shimniok/SerialLCDBackpack/README.md

# SerialLCDBackpack
Serial interface backpack for HD44780 LCD character displays
