shimniok/SerialLCDBackpack/electronics/serlcd841.brd

## EAGLE design electronics/serlcd841.brd (2021-02-10)

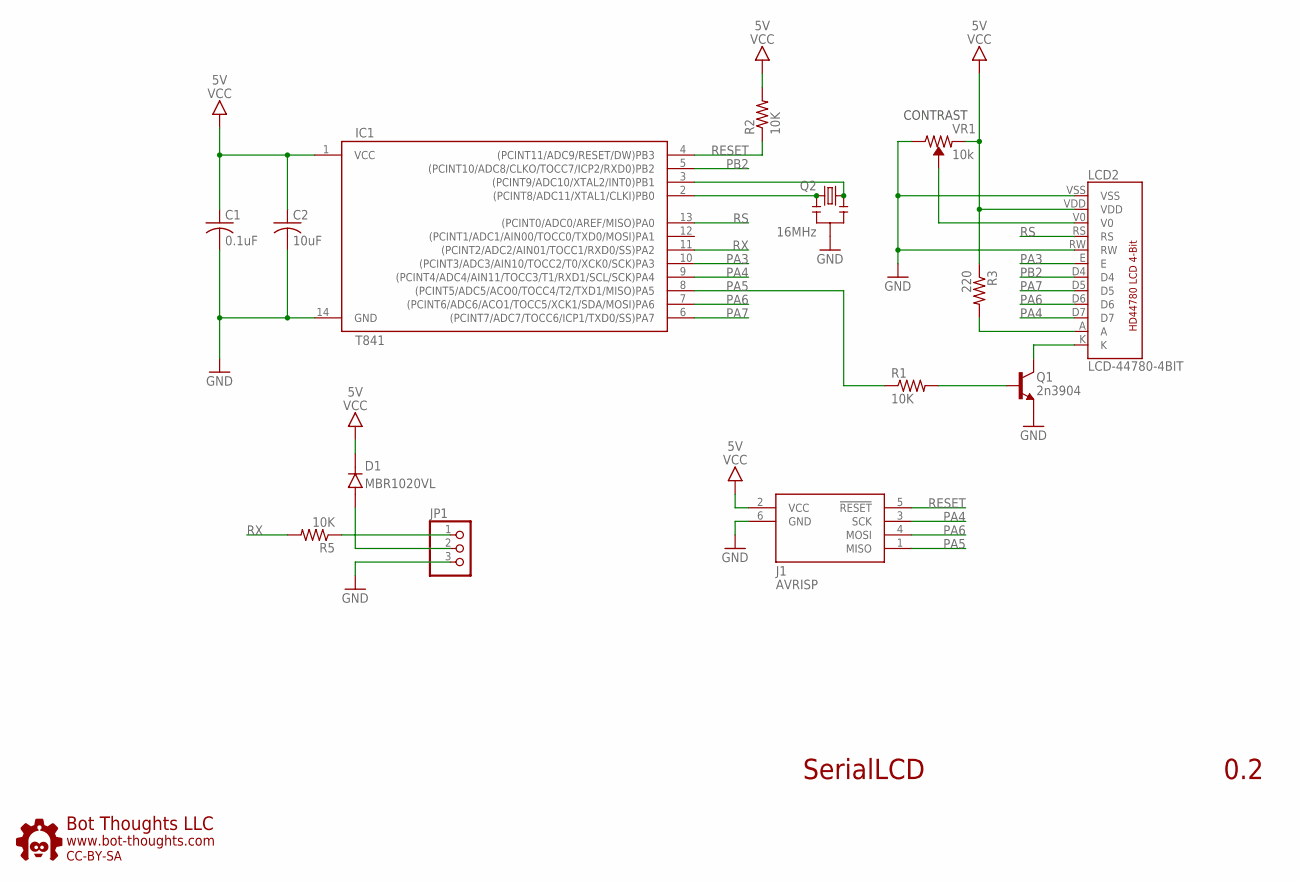
[picture p1: schematic serlcd841.sch]

Parts:
C1: 0.1uF; 0603
C2: 10uF; 1206
D1: MBR1020VL; SOD123FL
IC1: T841; SOIC14N
J1: AVRISP; CON6P2R
JP1: PINHD-1X03_2.54-S; 1X03-S
LCD2: LCD-44780-4BIT; LCD16SIP
Q1: 2n3904; SOT-23
Q2: 16MHz; CSTCE_V_C
R1, R2, R5: 10K; 0603
R3: 220; 0603
U$6: BTLOGO-LOGO-MD; BTLOGOM
VR1: 10k; TRIMPOT-SMD-TC33X

Connections:
A: LCD2.A, R3.2
GND: C1.2 (-), C2.2 (-), IC1.14 (GND), J1.6 (GND), JP1.3, LCD2.RW, LCD2.VSS, Q1.2 (E), Q2.GND, VR1.1 (CW)
unnamed: D1.A, JP1.2
unnamed: IC1.2 ((PCINT8/ADC11/XTAL1/CLKI)PB0), Q2.X2
unnamed: IC1.3 ((PCINT9/ADC10/XTAL2/INT0)PB1), Q2.X1
unnamed: Q1.3 (B), R1.2
unnamed: LCD2.K, Q1.1 (C)
PA3: IC1.10 ((PCINT3/ADC3/AIN10/TOCC2/T0/XCK0/SCK)PA3), LCD2.E
PA4: IC1.9 ((PCINT4/ADC4/AIN11/TOCC3/T1/RXD1/SCL/SC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), J1.3 (SCK), LCD2.D7
PA5: IC1.8 ((PCINT5/ADC5/ACO0/TOCC4/T2/TXD1/MISO)PA5), J1.1 (MISO), R1.1
PA6: IC1.7 ((PCINT6/ADC6/ACO1/TOCC5/XCK1/SDA/MOSI)P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), J1.4 (MOSI), LCD2.D6
PA7: IC1.6 ((PCINT7/ADC7/TOCC6/ICP1/TXD0/SS)PA7), LCD2.D5
PB2: IC1.5 ((PCINT10/ADC8/CLKO/TOCC7/ICP2/RXD0)PB2), LCD2.D4
RESET: IC1.4 ((PCINT11/ADC9/RESET/DW)PB3), J1.5 (!RESET), R2.1
RS: IC1.13 ((PCINT0/ADC0/AREF/MISO)PA0), LCD2.RS
RX: IC1.11 ((PCINT2/ADC2/AIN01/TOCC1/RXD0/SS)PA2), R5.2
RXI: JP1.1, R5.1
VCC: C1.1 (+), C2.1 (+), D1.C, IC1.1 (VCC), J1.2 (VCC), LCD2.VDD, R2.2, R3.1, VR1.3 (CCW)
VO: LCD2.V0, VR1.2 (WIPER)

Notes on the sheet:
SerialLCD
0.2
CONTRAST

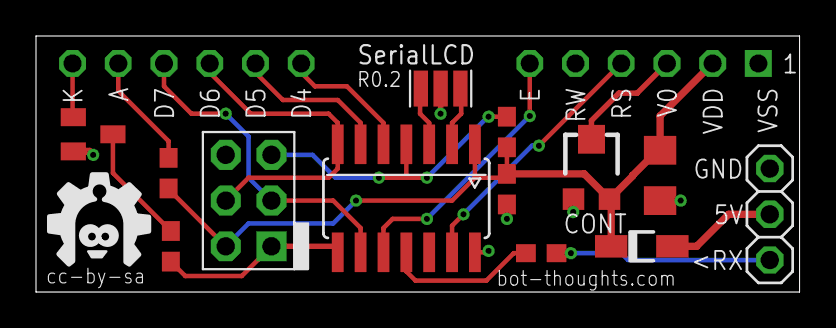
[picture p2: board serlcd841.brd from above]

Board: 2 copper layers, 42.4 x 14.2 mm, 15 parts (0 on the bottom side), 19 nets.
