shimniok/SerialLCDBackpack/electronics/I2C LCD Backpack v28.brd

## EAGLE design electronics/I2C LCD Backpack v28.brd (2017-06-09)

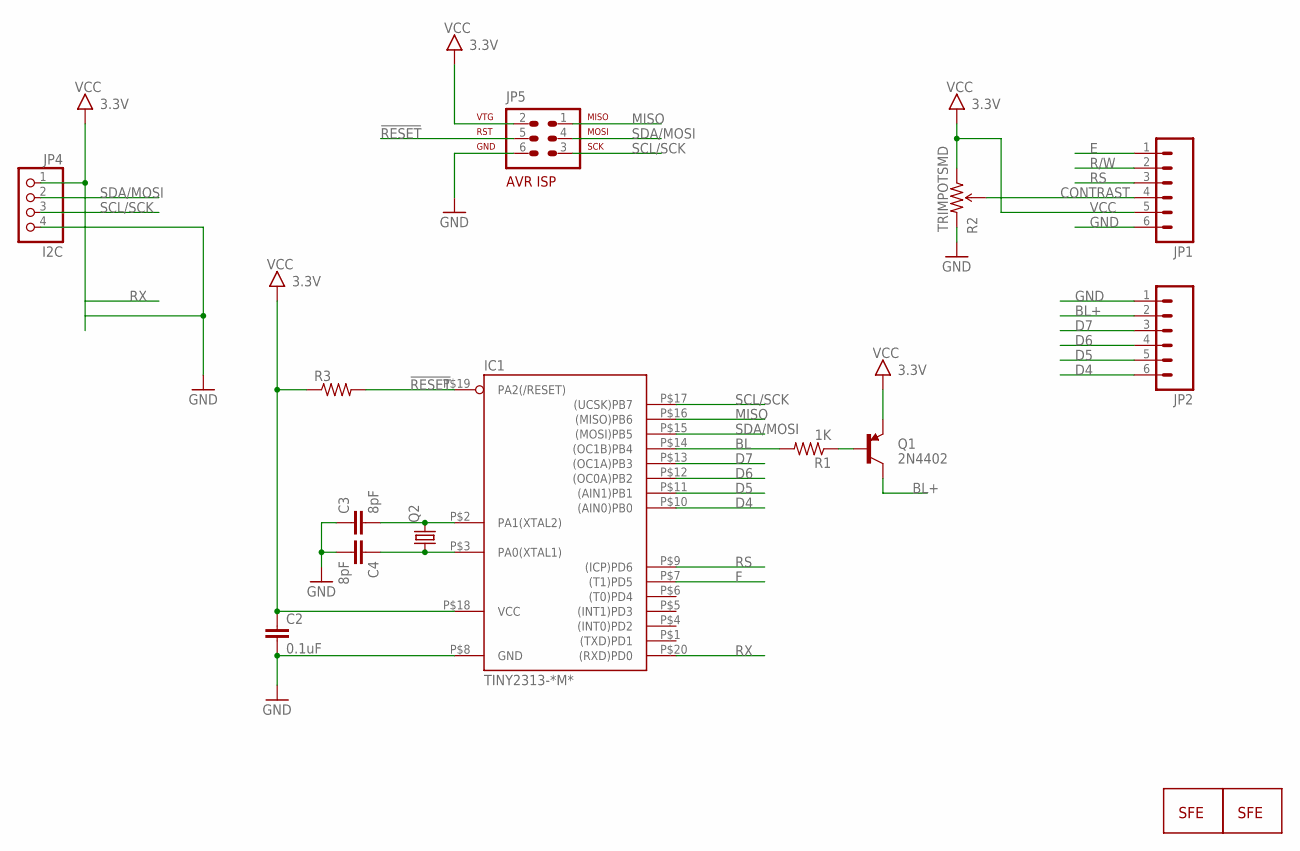
[picture p3: schematic I2C LCD Backpack v28.sch]

Parts:
C2: 0.1uF; 0603-CAP
C3, C4: 8pF; 0603-CAP
IC1: TINY2313-*M*; MLF20
JP1, JP2: M06LOCK; 1X06_LOCK
JP4: I2C; 1X04-S
JP5: AVR-ISP-6
Q1: 2N4402; SOT23-3
Q2: CRYSTALNDK5X3; NDK_2PAD_5X3
R1: 1K; 0402-RES
R2: TRIMPOTSMD; TRIMPOT-3MM
R3: R-US_R0603; R0603
U$2: LOGO-FLAME-LARGE
U$5: LOGO-SFENEW; SFE-NEW-WEBLOGO

Connections:
!RESET: IC1.P$19 (PA2(/RESET)), JP5.5, R3.2
BL: IC1.P$14 ((OC1B)PB4), R1.2
BL+: JP2.2, Q1.3 (C)
CONTRAST: JP1.4, R2.2 (WIPER)
D4: IC1.P$10 ((AIN0)PB0), JP2.6
D5: IC1.P$11 ((AIN1)PB1), JP2.5
D6: IC1.P$12 ((OC0A)PB2), JP2.4
D7: IC1.P$13 ((OC1A)PB3), JP2.3
E: JP1.1
F: IC1.P$7 ((T1)PD5)
GND: C2.2, C3.1, C4.2, IC1.P$8 (GND), JP1.6, JP2.1, JP4.4, JP5.6, R2.3 (CW)
MISO: IC1.P$16 ((MISO)PB6), JP5.1
unnamed: C4.1, IC1.P$3 (PA0(XTAL1)), Q2.P$1 (1)
unnamed: C3.2, IC1.P$2 (PA1(XTAL2)), Q2.P$2 (2)
unnamed: Q1.1 (B), R1.1
R/W: JP1.2
RS: IC1.P$9 ((ICP)PD6), JP1.3
RX: IC1.P$20 ((RXD)PD0)
SCL/SCK: IC1.P$17 ((UCSK)PB7), JP4.3, JP5.3
SDA/MOSI: IC1.P$15 ((MOSI)PB5), JP4.2, JP5.4
VCC: C2.1, IC1.P$18 (VCC), JP1.5, JP4.1, JP5.2, Q1.2 (E), R2.1 (CCW), R3.1

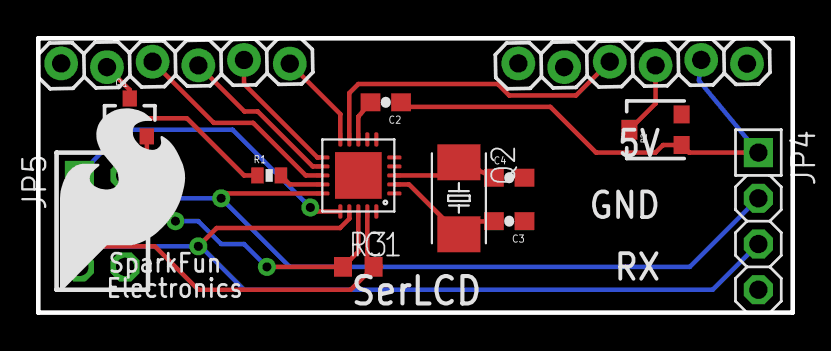
[picture p4: board I2C LCD Backpack v28.brd from above]

Board: 2 copper layers, 41.9 x 15.2 mm, 15 parts (1 on the bottom side), 17 nets.
