shimniok/SerialLCDBackpack/(threads)

Thread 3 (2017-06-27):

ATtiny841 seems to be bricking after < 24h of runtime.

shimniok, 2017-06-27:
The original prototype did not have this problem. After an hour or so runtime, the backpack becomes unresponsive. Reset / power cycle doesn't help.  Can no longer flash the chip, so it appears the chip is toast.

This has been duplicated 3 times now. Tested with a 5V zener across vcc/gnd but the problem still occurred.

shimniok, 2017-06-27:
Only difference between prototype and current version is use of a transistor to control the LED backlight.

The LED in the present design uses PA5 to sink current which happens to be a high sink pin (along with PA7). Datasheet graphs aren't clear to me but suggest high sink = 10mA max, extra high = 20mA max. Absolute max is 40mA. Datasheet graphs mention "Extra high sink" pins PA5/7... to enable extra high sink, set PHDE register bits PHDEA0 (for PA5).

Tested prototype with LED disconnected for a couple hours, no issues. Doing the same with new board, using high current setting.

shimniok, 2017-06-27:
setting PDHEA0 didn't work; chip died in about 2 hours. It's peer, running simultaneously, but without LED connection, is still going after about 3 hours.

shimniok, 2017-06-27:
Next test: 2n2222 with Rb = 10k, 330 ohm anode resistor.

shimniok, 2017-06-28:
Even with 2222 the chip bricked. Perhaps this is just a moisture issue or reflow too hot. Argh.
