shimniok/SerialLCDBackpack/(commit log)

2017-05-22 initial version
    [serlcd841.brd, serlcd841.sch]
2017-05-22 updated footprint for lcd, layout tweaks, switched some pins.
    [serlcd841.brd, serlcd841.sch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]
2017-05-22 backlight nmos rotation
    [serlcd841.brd]
2017-06-09 Corrected ISP connections, removed transistor for
    [I2C LCD Backpack v28.brd, I2C LCD Backpack v28.sch, Serial LCD Backpack v28.brd, Serial LCD Backpack v28.sch, serlcd841.brd, serlcd841.sch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]
2017-06-09 added arduino based firmware
2017-06-09 created arduino sketch dir
2017-06-09 fixed wire/pad clearance issues
    [serlcd841.brd]
2017-06-09 updated gerbers, zip
    [serlcd841.drills.xln]
2017-06-27 added code to set high current mode on PA5 for led backlight
2021-02-10 i don't remember :(
    [serlcd841.brd, serlcd841.sch]
