shimniok/SerialLCDBackpack/(notices)

Notices in the files:
electronics/serlcd841.brd:
cc-by-sa
parts and their libraries:
SparkFun-Resistors: Licensing: Creative Commons ShareAlike 4.0 International - https://creativecommons.org/licenses/by-sa/4.0
